homebrew8088/8088PCB/Kicad/Breadboard Adapter/Breadboard Adapter.kicad_pcb

## KiCad design Kicad/Breadboard Adapter/Breadboard Adapter.kicad_pcb (2025-01-31)

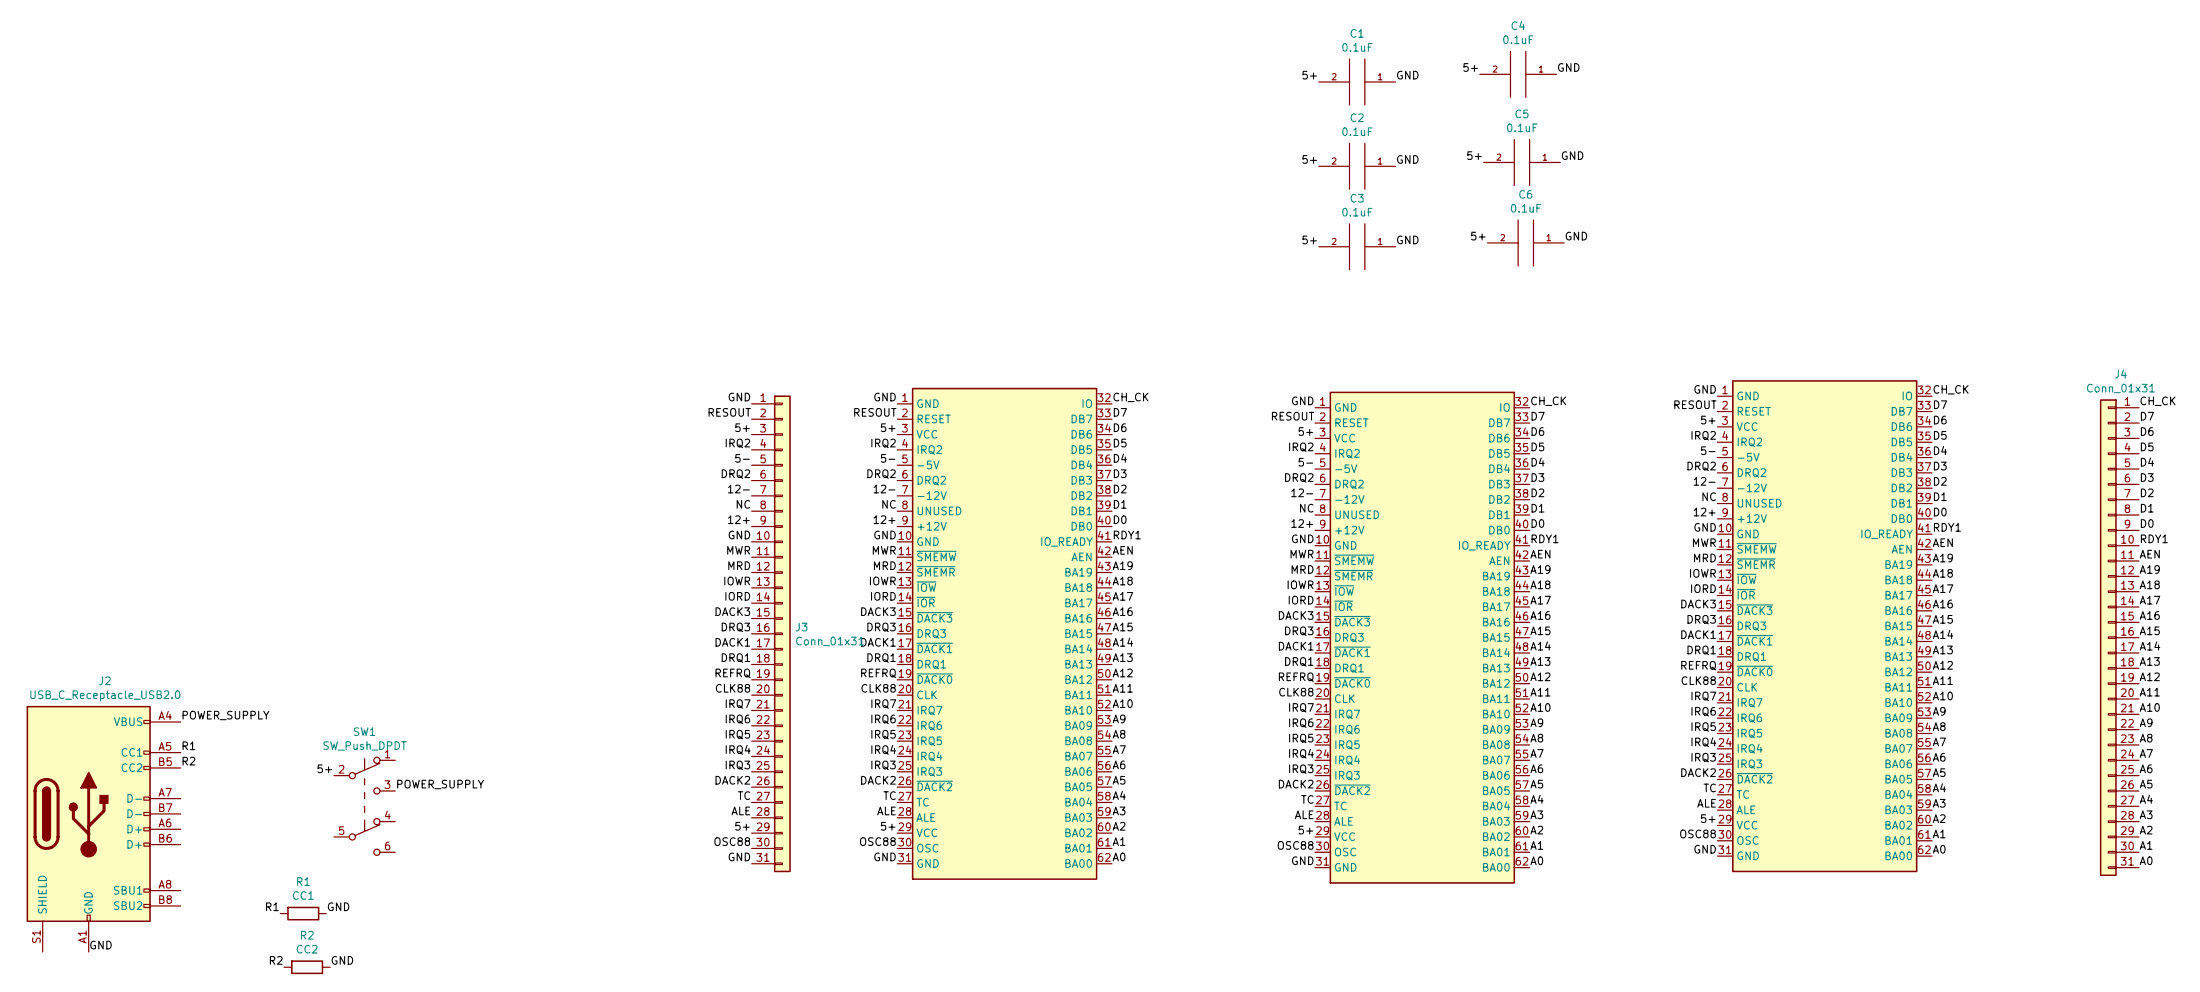
[picture p1: schematic Breadboard Adapter.sch]

Parts:
C1, C2, C3, C4, C5, C6: 0.1uF; C_Disc_D4.3mm_W1.9mm_P5.00mm
J1, J5, J9: Bus_ISA_8bit; 8-bit-ISA
J2: USB_C_Receptacle_USB2.0; USB_C_Receptacle_GCT_USB4085
J3, J4: Conn_01x31; PinHeader_1x31_P2.54mm_Vertical
R1: CC1; R_Axial_DIN0207_L6.3mm_D2.5mm_P10.16mm_Horizontal
R2: CC2; R_Axial_DIN0207_L6.3mm_D2.5mm_P10.16mm_Horizontal
SW1: SW_Push_DPDT; 6 PIN DTDP

Connections:
/5+: C1.2, C2.2, C3.2, C4.2, C5.2, C6.2, J1.3 (VCC), J1.29 (VCC), J3.3, J3.29, J5.3 (VCC), J5.29 (VCC), J9.3 (VCC), J9.29 (VCC), SW1.2 (B)
/5-: J1.5 (-5V), J3.5, J5.5 (-5V), J9.5 (-5V)
/12+: J1.9 (+12V), J3.9, J5.9 (+12V), J9.9 (+12V)
/12-: J1.7 (-12V), J3.7, J5.7 (-12V), J9.7 (-12V)
/A0: J1.62 (BA00), J4.31, J5.62 (BA00), J9.62 (BA00)
/A1: J1.61 (BA01), J4.30, J5.61 (BA01), J9.61 (BA01)
/A2: J1.60 (BA02), J4.29, J5.60 (BA02), J9.60 (BA02)
/A3: J1.59 (BA03), J4.28, J5.59 (BA03), J9.59 (BA03)
/A4: J1.58 (BA04), J4.27, J5.58 (BA04), J9.58 (BA04)
/A5: J1.57 (BA05), J4.26, J5.57 (BA05), J9.57 (BA05)
/A6: J1.56 (BA06), J4.25, J5.56 (BA06), J9.56 (BA06)
/A7: J1.55 (BA07), J4.24, J5.55 (BA07), J9.55 (BA07)
/A8: J1.54 (BA08), J4.23, J5.54 (BA08), J9.54 (BA08)
/A9: J1.53 (BA09), J4.22, J5.53 (BA09), J9.53 (BA09)
/A10: J1.52 (BA10), J4.21, J5.52 (BA10), J9.52 (BA10)
/A11: J1.51 (BA11), J4.20, J5.51 (BA11), J9.51 (BA11)
/A12: J1.50 (BA12), J4.19, J5.50 (BA12), J9.50 (BA12)
/A13: J1.49 (BA13), J4.18, J5.49 (BA13), J9.49 (BA13)
/A14: J1.48 (BA14), J4.17, J5.48 (BA14), J9.48 (BA14)
/A15: J1.47 (BA15), J4.16, J5.47 (BA15), J9.47 (BA15)
/A16: J1.46 (BA16), J4.15, J5.46 (BA16), J9.46 (BA16)
/A17: J1.45 (BA17), J4.14, J5.45 (BA17), J9.45 (BA17)
/A18: J1.44 (BA18), J4.13, J5.44 (BA18), J9.44 (BA18)
/A19: J1.43 (BA19), J4.12, J5.43 (BA19), J9.43 (BA19)
/AEN: J1.42 (AEN), J4.11, J5.42 (AEN), J9.42 (AEN)
/ALE: J1.28 (ALE), J3.28, J5.28 (ALE), J9.28 (ALE)
/CH_CK: J1.32 (IO), J4.1, J5.32 (IO), J9.32 (IO)
/CLK88: J1.20 (CLK), J3.20, J5.20 (CLK), J9.20 (CLK)
/D0: J1.40 (DB0), J4.9, J5.40 (DB0), J9.40 (DB0)
/D1: J1.39 (DB1), J4.8, J5.39 (DB1), J9.39 (DB1)
/D2: J1.38 (DB2), J4.7, J5.38 (DB2), J9.38 (DB2)
/D3: J1.37 (DB3), J4.6, J5.37 (DB3), J9.37 (DB3)
/D4: J1.36 (DB4), J4.5, J5.36 (DB4), J9.36 (DB4)
/D5: J1.35 (DB5), J4.4, J5.35 (DB5), J9.35 (DB5)
/D6: J1.34 (DB6), J4.3, J5.34 (DB6), J9.34 (DB6)
/D7: J1.33 (DB7), J4.2, J5.33 (DB7), J9.33 (DB7)
/DACK1: J1.17 (~DACK1), J3.17, J5.17 (~DACK1), J9.17 (~DACK1)
/DACK2: J1.26 (~DACK2), J3.26, J5.26 (~DACK2), J9.26 (~DACK2)
/DACK3: J1.15 (~DACK3), J3.15, J5.15 (~DACK3), J9.15 (~DACK3)
/DRQ1: J1.18 (DRQ1), J3.18, J5.18 (DRQ1), J9.18 (DRQ1)
/DRQ2: J1.6 (DRQ2), J3.6, J5.6 (DRQ2), J9.6 (DRQ2)
/DRQ3: J1.16 (DRQ3), J3.16, J5.16 (DRQ3), J9.16 (DRQ3)
/GND: C1.1, C2.1, C3.1, C4.1, C5.1, C6.1, J1.1 (GND), J1.10 (GND), J1.31 (GND), J2.A1 (GND), J2.A12 (GND), J2.B1 (GND), J2.B12 (GND), J3.1, J3.10, J3.31, J5.1 (GND), J5.10 (GND), J5.31 (GND), J9.1 (GND), J9.10 (GND), J9.31 (GND), R1.1, R2.1
/IORD: J1.14 (~IOR), J3.14, J5.14 (~IOR), J9.14 (~IOR)
/IOWR: J1.13 (~IOW), J3.13, J5.13 (~IOW), J9.13 (~IOW)
/IRQ2: J1.4 (IRQ2), J3.4, J5.4 (IRQ2), J9.4 (IRQ2)
/IRQ3: J1.25 (IRQ3), J3.25, J5.25 (IRQ3), J9.25 (IRQ3)
/IRQ4: J1.24 (IRQ4), J3.24, J5.24 (IRQ4), J9.24 (IRQ4)
/IRQ5: J1.23 (IRQ5), J3.23, J5.23 (IRQ5), J9.23 (IRQ5)
/IRQ6: J1.22 (IRQ6), J3.22, J5.22 (IRQ6), J9.22 (IRQ6)
/IRQ7: J1.21 (IRQ7), J3.21, J5.21 (IRQ7), J9.21 (IRQ7)
/MRD: J1.12 (~SMEMR), J3.12, J5.12 (~SMEMR), J9.12 (~SMEMR)
/MWR: J1.11 (~SMEMW), J3.11, J5.11 (~SMEMW), J9.11 (~SMEMW)
/NC: J1.8 (UNUSED), J3.8, J5.8 (UNUSED), J9.8 (UNUSED)
/OSC88: J1.30 (OSC), J3.30, J5.30 (OSC), J9.30 (OSC)
/POWER_SUPPLY: J2.A4 (VBUS), J2.A9 (VBUS), J2.B4 (VBUS), J2.B9 (VBUS), SW1.3 (C)
/R1: J2.A5 (CC1), R1.2
/R2: J2.B5 (CC2), R2.2
/RDY1: J1.41 (IO_READY), J4.10, J5.41 (IO_READY), J9.41 (IO_READY)
/REFRQ: J1.19 (~DACK0), J3.19, J5.19 (~DACK0), J9.19 (~DACK0)
/RESOUT: J1.2 (RESET), J3.2, J5.2 (RESET), J9.2 (RESET)
/TC: J1.27 (TC), J3.27, J5.27 (TC), J9.27 (TC)

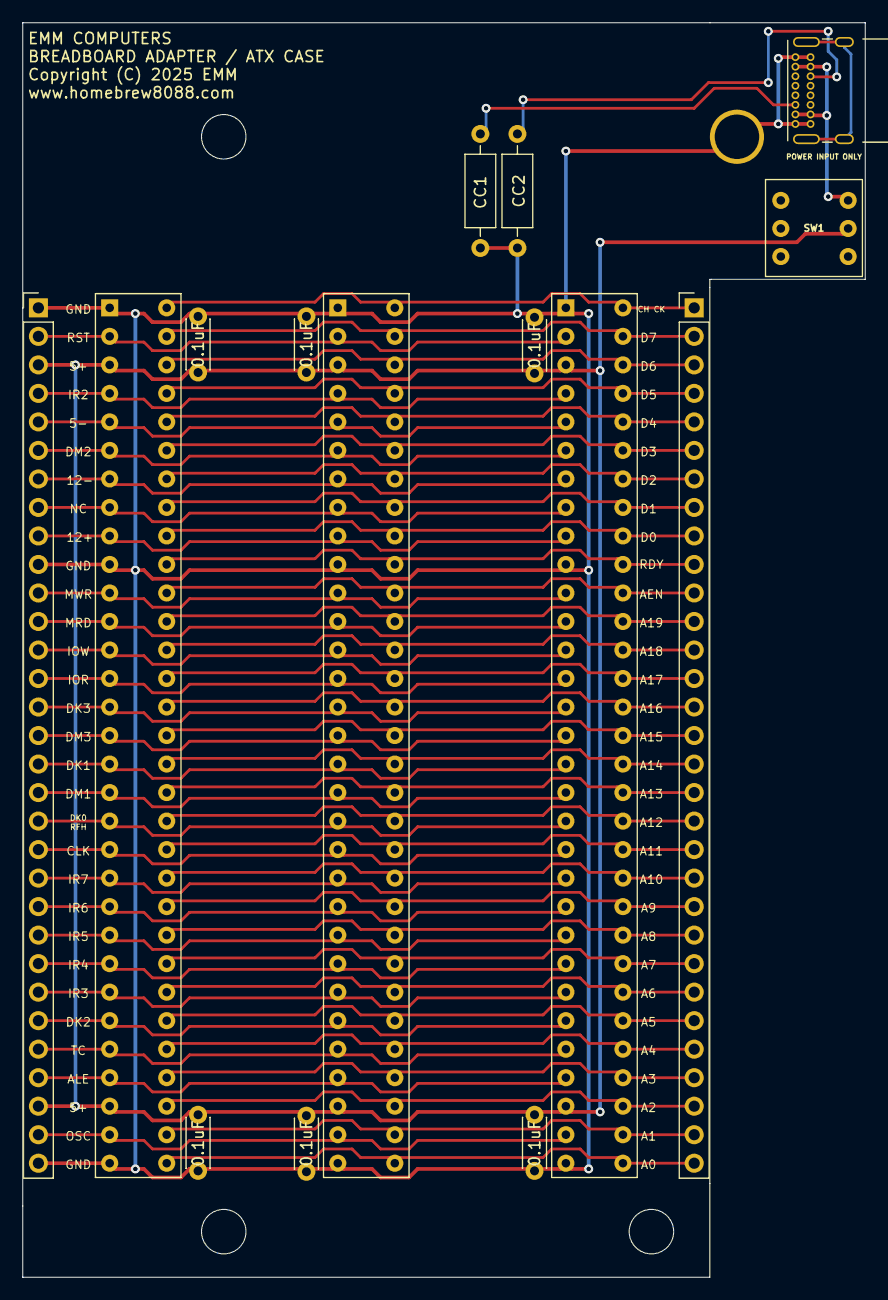
[picture p2: board Breadboard Adapter.kicad_pcb from above]

Board: 2 copper layers, 75.1 x 111.8 mm, 15 parts (0 on the bottom side), 62 nets.
