homebrew8088/8088PCB/Kicad/Motherboard/8088 PCB.kicad_pcb

## KiCad design Kicad/Motherboard/8088 PCB.kicad_pcb (2024-06-24)

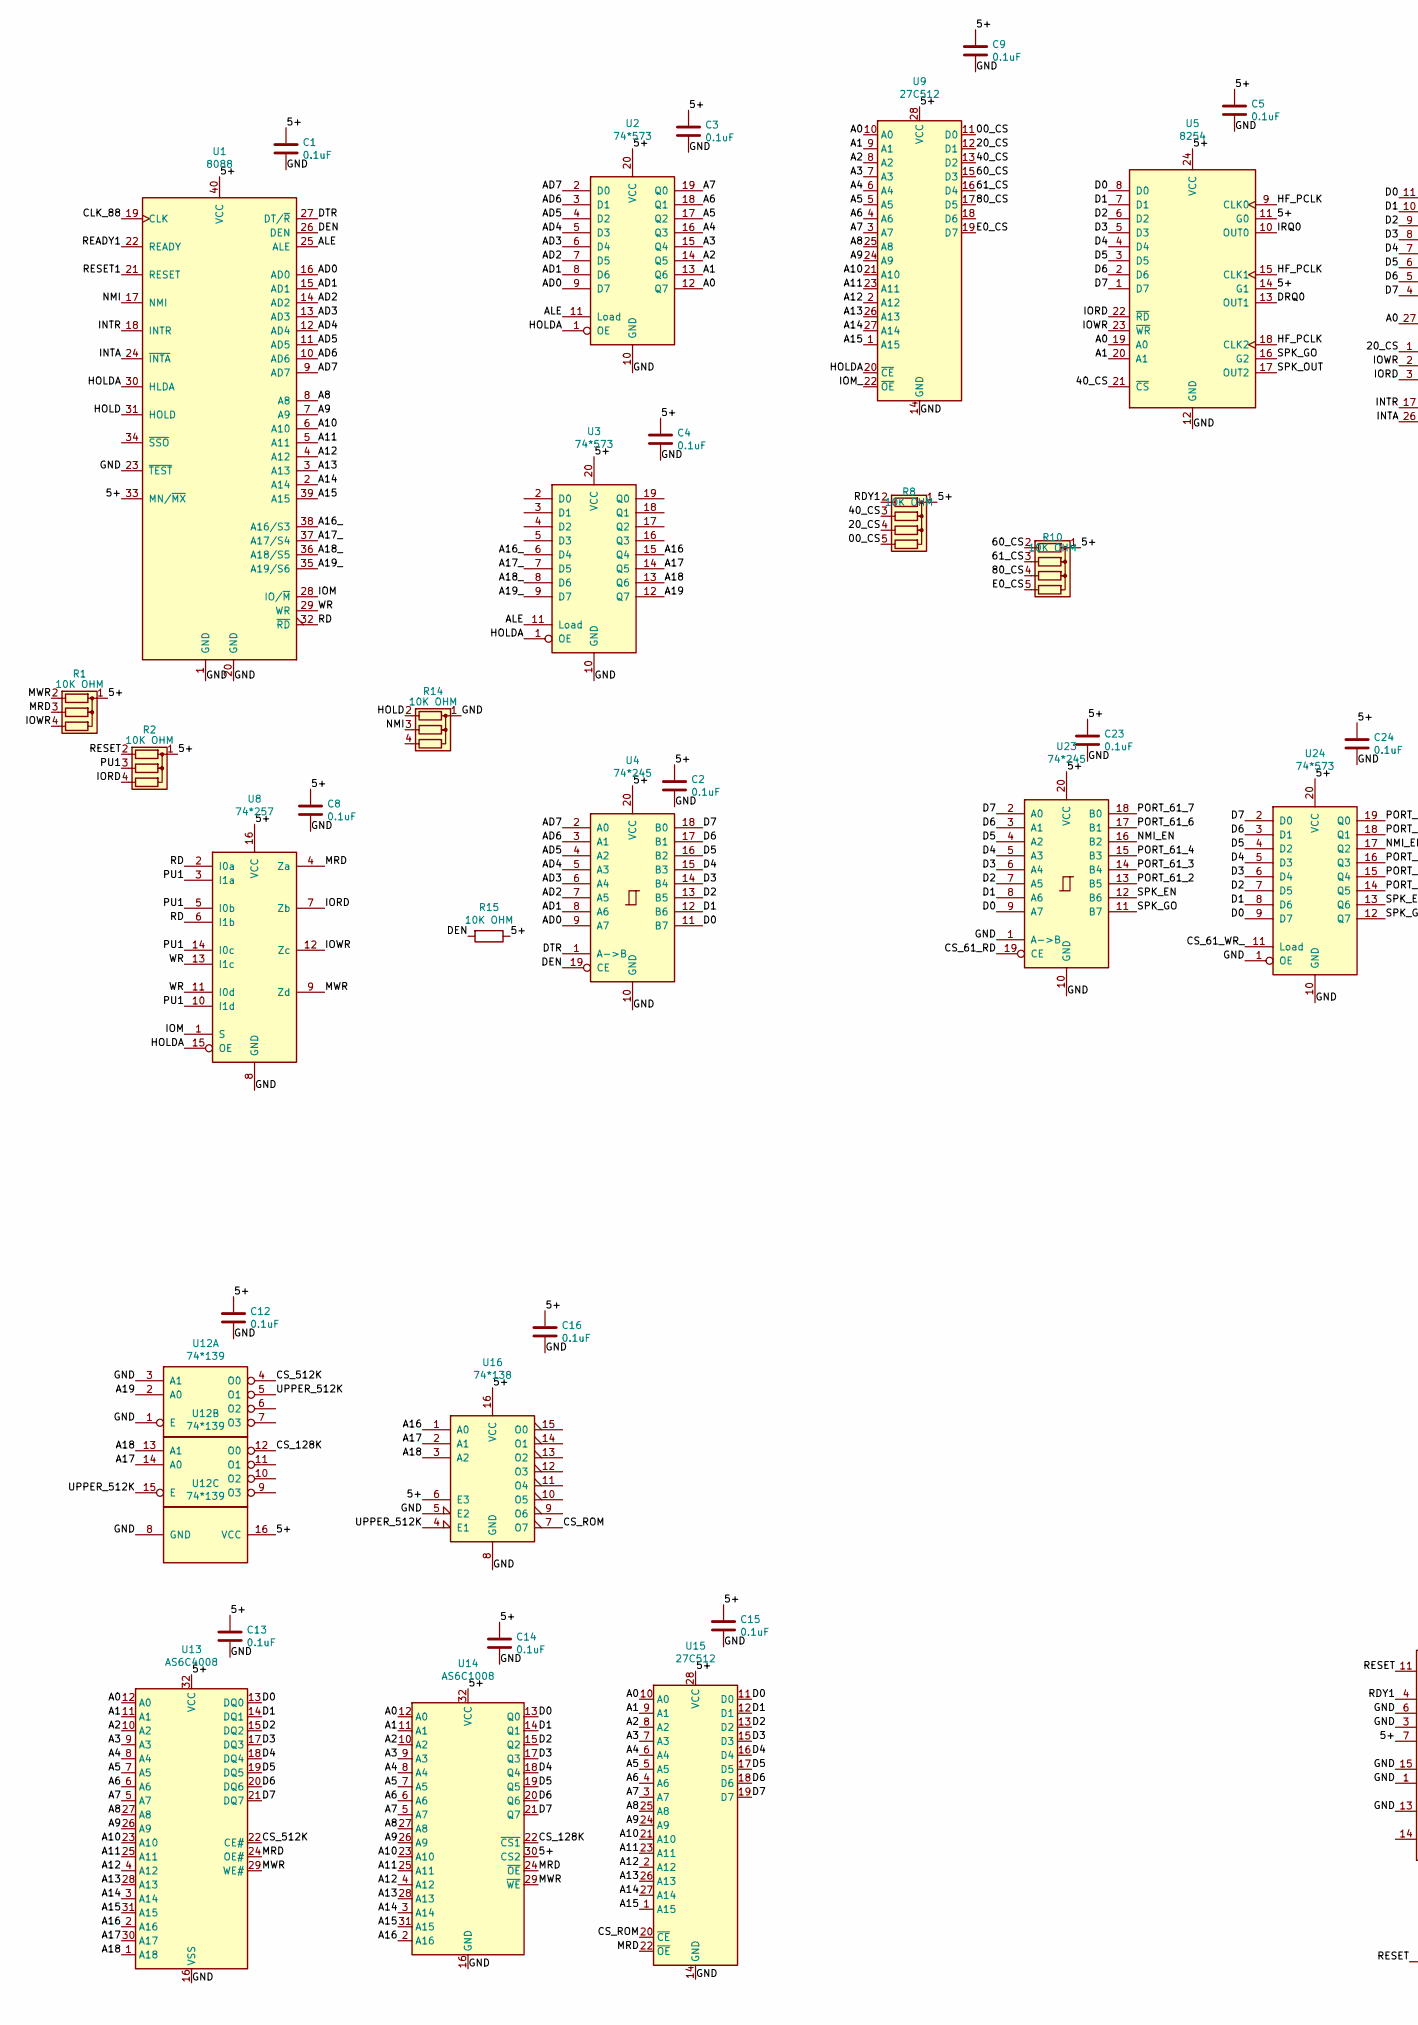
[picture p3: schematic 8088 PCB.sch, part in row 1, column 1]

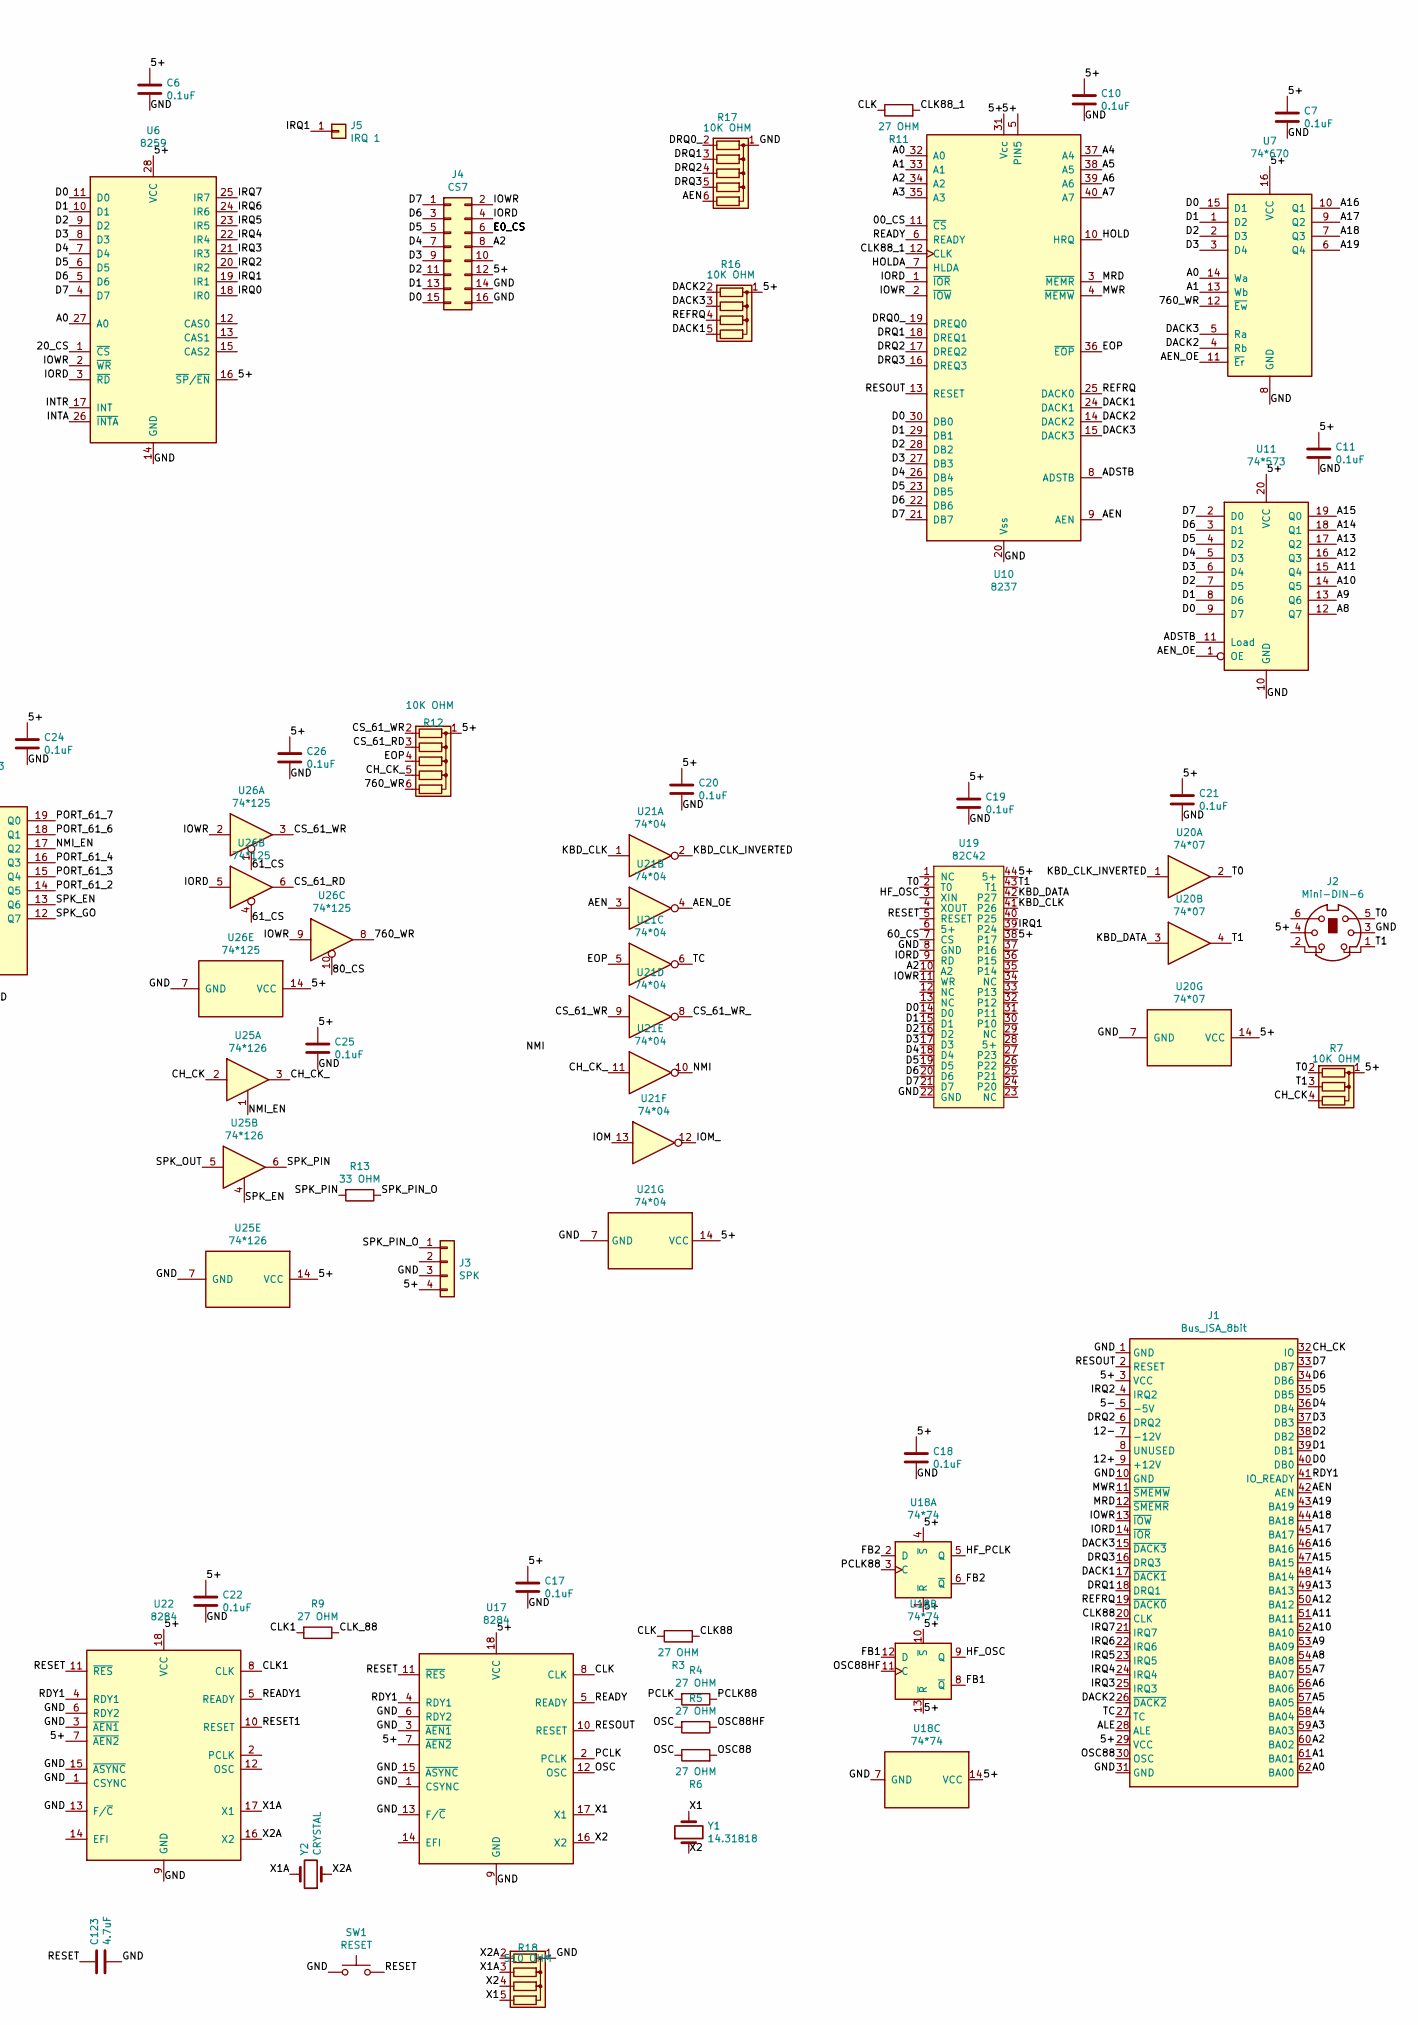
[picture p4: schematic 8088 PCB.sch, part in row 1, column 2]

Parts:
C1, C2, C3, C4, C5, C6, C7, C8, C9, C10, C11, C12, C13, C14, C15, C16, C17, C18, C19, C20, C21, C22, C23, C24, C25, C26: 0.1uF; C_Disc_D4.3mm_W1.9mm_P5.00mm
C123: 4.7uF; CP_Radial_D4.0mm_P1.50mm
J1: Bus_ISA_8bit; BUS_8_BIT
J2: Mini-DIN-6; 6_PIN_DIN
J3: SPK; PinHeader_1x04_P2.54mm_Vertical
J4: CS7; PinHeader_2x08_P2.54mm_Vertical
J5: IRQ 1; PinHeader_1x01_P2.54mm_Vertical
R1, R2, R7, R14: 10K OHM; R_Array_SIP4
R3, R4, R5, R6, R9, R11: 27 OHM; R_Axial_DIN0207_L6.3mm_D2.5mm_P10.16mm_Horizontal
R8, R10, R16: 10K OHM; R_Array_SIP5
R12, R17: 10K OHM; R_Array_SIP6
R13: 33 OHM; R_Axial_DIN0207_L6.3mm_D2.5mm_P10.16mm_Horizontal
R15: 10K OHM; R_Axial_DIN0207_L6.3mm_D2.5mm_P10.16mm_Horizontal
R18: 510 OHM; R_Array_SIP5
SW1: RESET; SW_PUSH_6mm
U1: 8088; DIP-40_W15.24mm
U2, U3, U11, U24: 74*573; DIP-20_W7.62mm
U4, U23: 74*245; DIP-20_W7.62mm
U5: 8254; DIP-24_W15.24mm
U6: 8259; DIP-28_W15.24mm
U7: 74*670; DIP-16_W7.62mm
U8: 74*257; DIP-16_W7.62mm
U9, U15: 27C512; DIP-28_W15.24mm
U10: 8237; DIP-40_W15.24mm
U12: 74*139; DIP-16_W7.62mm
U13: AS6C4008; DIP-32_W15.24mm
U14: AS6C1008; DIP-32_W15.24mm
U16: 74*138; DIP-16_W7.62mm
U17, U22: 8284; DIP-18_W7.62mm
U18: 74*74; DIP-14_W7.62mm
U19: 82C42; PLCC-44_THT-Socket
U20: 74*07; DIP-14_W7.62mm
U21: 74*04; DIP-14_W7.62mm
U25: 74*126; DIP-14_W7.62mm
U26: 74*125; DIP-14_W7.62mm
Y1: 14.31818; Crystal_HC18-U_Vertical
Y2: CRYSTAL; Crystal_HC18-U_Vertical

Connections:
/00_CS: R8.5 (R4), U9.11 (D0), U10.11 (~CS~)
/5+: C1.1, C2.1, C3.1, C4.1, C5.1, C6.1, C7.1, C8.1, C9.1, C10.1, C11.1, C12.1, C13.1, C14.1, C15.1, C16.1, C17.1, C18.1, C19.1, C20.1, C21.1, C22.1, C23.1, C24.1, C25.1, C26.1, J1.3 (VCC), J1.29 (VCC), J2.4, J3.4, J4.12, R1.1 (common), R2.1 (common), R7.1 (common), R8.1 (common), R10.1 (common), R12.1 (common), R15.1, R16.1 (common), U1.33 (MN/~MX~), U1.40 (VCC), U2.20 (VCC), U3.20 (VCC), U4.20 (VCC), U5.11 (G0), U5.14 (G1), U5.24 (VCC), U6.16 (~SP~/~EN~), U6.28 (VCC), U7.16 (VCC), U8.16 (VCC), U9.28 (VCC), U10.5 (PIN5), U10.31 (Vcc), U11.20 (VCC), U12.16 (VCC), U13.32 (VCC), U14.30 (CS2), U14.32 (VCC), U15.28 (VCC), U16.6 (E3), U16.16 (VCC), U17.7 (~AEN2~), U17.18 (VCC), U18.1 (~R), U18.4 (~S), U18.10 (~S), U18.13 (~R), U18.14 (VCC), U19.38 (P17), U19.44 (5+), U20.14 (VCC), U21.14 (VCC), U22.7 (~AEN2~), U22.18 (VCC), U23.20 (VCC), U24.20 (VCC), U25.14 (VCC), U26.14 (VCC)
/5-: J1.5 (-5V)
/12+: J1.9 (+12V)
/12-: J1.7 (-12V)
/20_CS: R8.4 (R3), U6.1 (~CS~), U9.12 (D1)
/40_CS: R8.3 (R2), U5.21 (~CS~), U9.13 (D2)
/60_CS: R10.2 (R1), U9.15 (D3), U19.7 (CS)
/61_CS: R10.3 (R2), U9.16 (D4), U26.1, U26.4
/80_CS: R10.4 (R3), U9.17 (D5), U26.10
/760_WR: R12.6 (R5), U7.12 (~Ew), U26.8
/A0: J1.62 (BA00), U2.12 (Q7), U5.19 (A0), U6.27 (A0), U7.14 (Wa), U9.10 (A0), U10.32 (A0), U13.12 (A0), U14.12 (A0), U15.10 (A0)
/A1: J1.61 (BA01), U2.13 (Q6), U5.20 (A1), U7.13 (Wb), U9.9 (A1), U10.33 (A1), U13.11 (A1), U14.11 (A1), U15.9 (A1)
/A2: J1.60 (BA02), J4.8, U2.14 (Q5), U9.8 (A2), U10.34 (A2), U13.10 (A2), U14.10 (A2), U15.8 (A2), U19.10 (A2)
/A3: J1.59 (BA03), U2.15 (Q4), U9.7 (A3), U10.35 (A3), U13.9 (A3), U14.9 (A3), U15.7 (A3)
/A4: J1.58 (BA04), U2.16 (Q3), U9.6 (A4), U10.37 (A4), U13.8 (A4), U14.8 (A4), U15.6 (A4)
/A5: J1.57 (BA05), U2.17 (Q2), U9.5 (A5), U10.38 (A5), U13.7 (A5), U14.7 (A5), U15.5 (A5)
/A6: J1.56 (BA06), U2.18 (Q1), U9.4 (A6), U10.39 (A6), U13.6 (A6), U14.6 (A6), U15.4 (A6)
/A7: J1.55 (BA07), U2.19 (Q0), U9.3 (A7), U10.40 (A7), U13.5 (A7), U14.5 (A7), U15.3 (A7)
/A8: J1.54 (BA08), U1.8 (A8), U9.25 (A8), U11.12 (Q7), U13.27 (A8), U14.27 (A8), U15.25 (A8)
/A9: J1.53 (BA09), U1.7 (A9), U9.24 (A9), U11.13 (Q6), U13.26 (A9), U14.26 (A9), U15.24 (A9)
/A10: J1.52 (BA10), U1.6 (A10), U9.21 (A10), U11.14 (Q5), U13.23 (A10), U14.23 (A10), U15.21 (A10)
/A11: J1.51 (BA11), U1.5 (A11), U9.23 (A11), U11.15 (Q4), U13.25 (A11), U14.25 (A11), U15.23 (A11)
/A12: J1.50 (BA12), U1.4 (A12), U9.2 (A12), U11.16 (Q3), U13.4 (A12), U14.4 (A12), U15.2 (A12)
/A13: J1.49 (BA13), U1.3 (A13), U9.26 (A13), U11.17 (Q2), U13.28 (A13), U14.28 (A13), U15.26 (A13)
/A14: J1.48 (BA14), U1.2 (A14), U9.27 (A14), U11.18 (Q1), U13.3 (A14), U14.3 (A14), U15.27 (A14)
/A15: J1.47 (BA15), U1.39 (A15), U9.1 (A15), U11.19 (Q0), U13.31 (A15), U14.31 (A15), U15.1 (A15)
/A16: J1.46 (BA16), U3.15 (Q4), U7.10 (Q1), U13.2 (A16), U14.2 (A16), U16.1 (A0)
/A16_: U1.38 (A16/S3), U3.6 (D4)
/A17: J1.45 (BA17), U3.14 (Q5), U7.9 (Q2), U12.14 (A0), U13.30 (A17), U16.2 (A1)
/A17_: U1.37 (A17/S4), U3.7 (D5)
/A18: J1.44 (BA18), U3.13 (Q6), U7.7 (Q3), U12.13 (A1), U13.1 (A18), U16.3 (A2)
/A18_: U1.36 (A18/S5), U3.8 (D6)
/A19: J1.43 (BA19), U3.12 (Q7), U7.6 (Q4), U12.2 (A0)
/A19_: U1.35 (A19/S6), U3.9 (D7)
/AD0: U1.16 (AD0), U2.9 (D7), U4.9 (A7)
/AD1: U1.15 (AD1), U2.8 (D6), U4.8 (A6)
/AD2: U1.14 (AD2), U2.7 (D5), U4.7 (A5)
/AD3: U1.13 (AD3), U2.6 (D4), U4.6 (A4)
/AD4: U1.12 (AD4), U2.5 (D3), U4.5 (A3)
/AD5: U1.11 (AD5), U2.4 (D2), U4.4 (A2)
/AD6: U1.10 (AD6), U2.3 (D1), U4.3 (A1)
/AD7: U1.9 (AD7), U2.2 (D0), U4.2 (A0)
/ADSTB: U10.8 (ADSTB), U11.11 (Load)
/AEN: J1.42 (AEN), R17.6 (R5), U10.9 (AEN), U21.3
/AEN_OE: U7.11 (~Er), U11.1 (OE), U21.4
/ALE: J1.28 (ALE), U1.25 (ALE), U2.11 (Load), U3.11 (Load)
/CH_CK: J1.32 (IO), R7.4 (R3), U25.2
/CH_CK_: R12.5 (R4), U21.11, U25.3
/CLK: R3.1, R11.1, U17.8 (CLK)
/CLK1: R9.2, U22.8 (CLK)
/CLK88: J1.20 (CLK), R3.2
/CLK88_1: R11.2, U10.12 (CLK)
/CLK_88: R9.1, U1.19 (CLK)
/CS_61_RD: R12.3 (R2), U23.19 (CE), U26.6
/CS_61_WR: R12.2 (R1), U21.9, U26.3
/CS_61_WR_: U21.8, U24.11 (Load)
/CS_128K: U12.12 (O0), U14.22 (~CS1)
/CS_512K: U12.4 (O0), U13.22 (CE#)
/CS_ROM: U15.20 (~CE), U16.7 (O7)
/D0: J1.40 (DB0), J4.15, U4.11 (B7), U5.8 (D0), U6.11 (D0), U7.15 (D1), U10.30 (DB0), U11.9 (D7), U13.13 (DQ0), U14.13 (Q0), U15.11 (D0), U19.14 (D0), U23.9 (A7), U24.9 (D7)
/D1: J1.39 (DB1), J4.13, U4.12 (B6), U5.7 (D1), U6.10 (D1), U7.1 (D2), U10.29 (DB1), U11.8 (D6), U13.14 (DQ1), U14.14 (Q1), U15.12 (D1), U19.15 (D1), U23.8 (A6), U24.8 (D6)
/D2: J1.38 (DB2), J4.11, U4.13 (B5), U5.6 (D2), U6.9 (D2), U7.2 (D3), U10.28 (DB2), U11.7 (D5), U13.15 (DQ2), U14.15 (Q2), U15.13 (D2), U19.16 (D2), U23.7 (A5), U24.7 (D5)
/D3: J1.37 (DB3), J4.9, U4.14 (B4), U5.5 (D3), U6.8 (D3), U7.3 (D4), U10.27 (DB3), U11.6 (D4), U13.17 (DQ3), U14.17 (Q3), U15.15 (D3), U19.17 (D3), U23.6 (A4), U24.6 (D4)
/D4: J1.36 (DB4), J4.7, U4.15 (B3), U5.4 (D4), U6.7 (D4), U10.26 (DB4), U11.5 (D3), U13.18 (DQ4), U14.18 (Q4), U15.16 (D4), U19.18 (D4), U23.5 (A3), U24.5 (D3)
/D5: J1.35 (DB5), J4.5, U4.16 (B2), U5.3 (D5), U6.6 (D5), U10.23 (DB5), U11.4 (D2), U13.19 (DQ5), U14.19 (Q5), U15.17 (D5), U19.19 (D5), U23.4 (A2), U24.4 (D2)
/D6: J1.34 (DB6), J4.3, U4.17 (B1), U5.2 (D6), U6.5 (D6), U10.22 (DB6), U11.3 (D1), U13.20 (DQ6), U14.20 (Q6), U15.18 (D6), U19.20 (D6), U23.3 (A1), U24.3 (D1)
/D7: J1.33 (DB7), J4.1, U4.18 (B0), U5.1 (D7), U6.4 (D7), U10.21 (DB7), U11.2 (D0), U13.21 (DQ7), U14.21 (Q7), U15.19 (D7), U19.21 (D7), U23.2 (A0), U24.2 (D0)
/DACK1: J1.17 (~DACK1), R16.5 (R4), U10.24 (DACK1)
/DACK2: J1.26 (~DACK2), R16.2 (R1), U7.4 (Rb), U10.14 (DACK2)
/DACK3: J1.15 (~DACK3), R16.3 (R2), U7.5 (Ra), U10.15 (DACK3)
/DEN: R15.2, U1.26 (DEN), U4.19 (CE)
/DRQ0: U5.13 (OUT1)
/DRQ0_: R17.2 (R1), U10.19 (DREQ0)
/DRQ1: J1.18 (DRQ1), R17.3 (R2), U10.18 (DREQ1)
/DRQ2: J1.6 (DRQ2), R17.4 (R3), U10.17 (DREQ2)
/DRQ3: J1.16 (DRQ3), R17.5 (R4), U10.16 (DREQ3)
/DTR: U1.27 (DT/~R~), U4.1 (A->B)
/E0_CS: J4.6, R10.5 (R4), U9.19 (D7)
/EOP: R12.4 (R3), U10.36 (~EOP~), U21.5
/FB1: U18.8 (~Q), U18.12 (D)
/FB2: U18.2 (D), U18.6 (~Q)
/GND: C1.2, C2.2, C3.2, C4.2, C5.2, C6.2, C7.2, C8.2, C9.2, C10.2, C11.2, C12.2, C13.2, C14.2, C15.2, C16.2, C17.2, C18.2, C19.2, C20.2, C21.2, C22.2, C23.2, C24.2, C25.2, C26.2, C123.2, J1.1 (GND), J1.10 (GND), J1.31 (GND), J2.3, J3.3, J4.14, J4.16, R14.1 (common), R17.1 (common), R18.1 (common), SW1.1, U1.1 (GND), U1.20 (GND), U1.23 (~TEST~), U2.10 (GND), U3.10 (GND), U4.10 (GND), U5.12 (GND), U6.14 (GND), U7.8 (GND), U8.8 (GND), U9.14 (GND), U10.20 (Vss), U11.10 (GND), U12.1 (E), U12.3 (A1), U12.8 (GND), U13.16 (VSS), U14.16 (GND), U15.14 (GND), U16.5 (E2), U16.8 (GND), U17.1 (CSYNC), U17.3 (~AEN1~), U17.6 (RDY2), U17.9 (GND), U17.13 (F/~C~), U17.15 (~ASYNC~), U18.7 (GND), U19.8 (GND), U19.22 (GND), U20.7 (GND), U21.7 (GND), U22.1 (CSYNC), U22.3 (~AEN1~), U22.6 (RDY2), U22.9 (GND), U22.13 (F/~C~), U22.15 (~ASYNC~), U23.1 (A->B), U23.10 (GND), U24.1 (OE), U24.10 (GND), U25.7 (GND), U26.7 (GND); also elsewhere on the board
/HF_OSC: U18.9 (Q), U19.3 (XIN)
/HF_PCLK: U5.9 (CLK0), U5.15 (CLK1), U5.18 (CLK2), U18.5 (Q)
/HOLD: R14.2 (R1), U1.31 (HOLD), U10.10 (HRQ)
/HOLDA: U1.30 (HLDA), U2.1 (OE), U3.1 (OE), U8.15 (OE), U9.20 (~CE), U10.7 (HLDA)
/INTA: U1.24 (~INTA~), U6.26 (~INTA~)
/INTR: U1.18 (INTR), U6.17 (INT)
/IOM: U1.28 (IO/~M~), U8.1 (S), U21.13
/IOM_: U9.22 (~OE), U21.12
/IORD: J1.14 (~IOR), J4.4, R2.4 (R3), U5.22 (~RD~), U6.3 (~RD~), U8.7 (Zb), U10.1 (~IOR~), U19.9 (RD), U26.5
/IOWR: J1.13 (~IOW), J4.2, R1.4 (R3), U5.23 (~WR~), U6.2 (~WR~), U8.12 (Zc), U10.2 (~IOW~), U19.11 (WR), U26.2, U26.9
/IRQ0: U5.10 (OUT0), U6.18 (IR0)
/IRQ1: J5.1, U6.19 (IR1), U19.39 (P24)
/IRQ2: J1.4 (IRQ2), U6.20 (IR2)
/IRQ3: J1.25 (IRQ3), U6.21 (IR3)
/IRQ4: J1.24 (IRQ4), U6.22 (IR4)
/IRQ5: J1.23 (IRQ5), U6.23 (IR5)
/IRQ6: J1.22 (IRQ6), U6.24 (IR6)
/IRQ7: J1.21 (IRQ7), U6.25 (IR7)
/KBD_CLK: U19.41 (P26), U21.1
/KBD_CLK_INVERTED: U20.1, U21.2
/KBD_DATA: U19.42 (P27), U20.3
/MRD: J1.12 (~SMEMR), R1.3 (R2), U8.4 (Za), U10.3 (~MEMR~), U13.24 (OE#), U14.24 (~OE), U15.22 (~OE)
/MWR: J1.11 (~SMEMW), R1.2 (R1), U8.9 (Zd), U10.4 (~MEMW~), U13.29 (WE#), U14.29 (~WE)
/NMI: R14.3 (R2), U1.17 (NMI), U21.10
/NMI_EN: U23.16 (B2), U24.17 (Q2), U25.1
/OSC: R5.2, R6.1, U17.12 (OSC)
/OSC88: J1.30 (OSC), R6.2
/OSC88HF: R5.1, U18.11 (C)
/PCLK: R4.2, U17.2 (PCLK)
/PCLK88: R4.1, U18.3 (C)
/PORT_61_2: U23.13 (B5), U24.14 (Q5)
/PORT_61_3: U23.14 (B4), U24.15 (Q4)
/PORT_61_4: U23.15 (B3), U24.16 (Q3)
/PORT_61_6: U23.17 (B1), U24.18 (Q1)
/PORT_61_7: U23.18 (B0), U24.19 (Q0)
/PU1: R2.3 (R2), U8.3 (I1a), U8.5 (I0b), U8.10 (I1d), U8.14 (I0c)
/RD: U1.32 (~RD~), U8.2 (I0a), U8.6 (I1b)
/RDY1: J1.41 (IO_READY), R8.2 (R1), U17.4 (RDY1), U22.4 (RDY1)
/READY: U10.6 (READY), U17.5 (READY)
/READY1: U1.22 (READY), U22.5 (READY)
/REFRQ: J1.19 (~DACK0), R16.4 (R3), U10.25 (DACK0)
/RESET: C123.1, R2.2 (R1), SW1.2, U17.11 (~RES~), U19.5 (RESET), U22.11 (~RES~)
/RESET1: U1.21 (RESET), U22.10 (RESET)
/RESOUT: J1.2 (RESET), U10.13 (RESET), U17.10 (RESET)
/SPK_EN: U23.12 (B6), U24.13 (Q6), U25.4
/SPK_GO: U5.16 (G2), U23.11 (B7), U24.12 (Q7)
/SPK_OUT: U5.17 (OUT2), U25.5
/SPK_PIN: R13.2, U25.6
/SPK_PIN_O: J3.1, R13.1
/T0: J2.5, R7.2 (R1), U19.2 (T0), U20.2
/T1: J2.1, R7.3 (R2), U19.43 (T1), U20.4
/TC: J1.27 (TC), U21.6
/UPPER_512K: U12.5 (O1), U12.15 (E), U16.4 (E1)
/WR: U1.29 (WR), U8.11 (I0d), U8.13 (I1c)
/X1: R18.5 (R4), U17.17 (X1), Y1.2
/X1A: R18.3 (R2), U22.17 (X1), Y2.2
/X2: R18.4 (R3), U17.16 (X2), Y1.1
/X2A: R18.2 (R1), U22.16 (X2), Y2.1

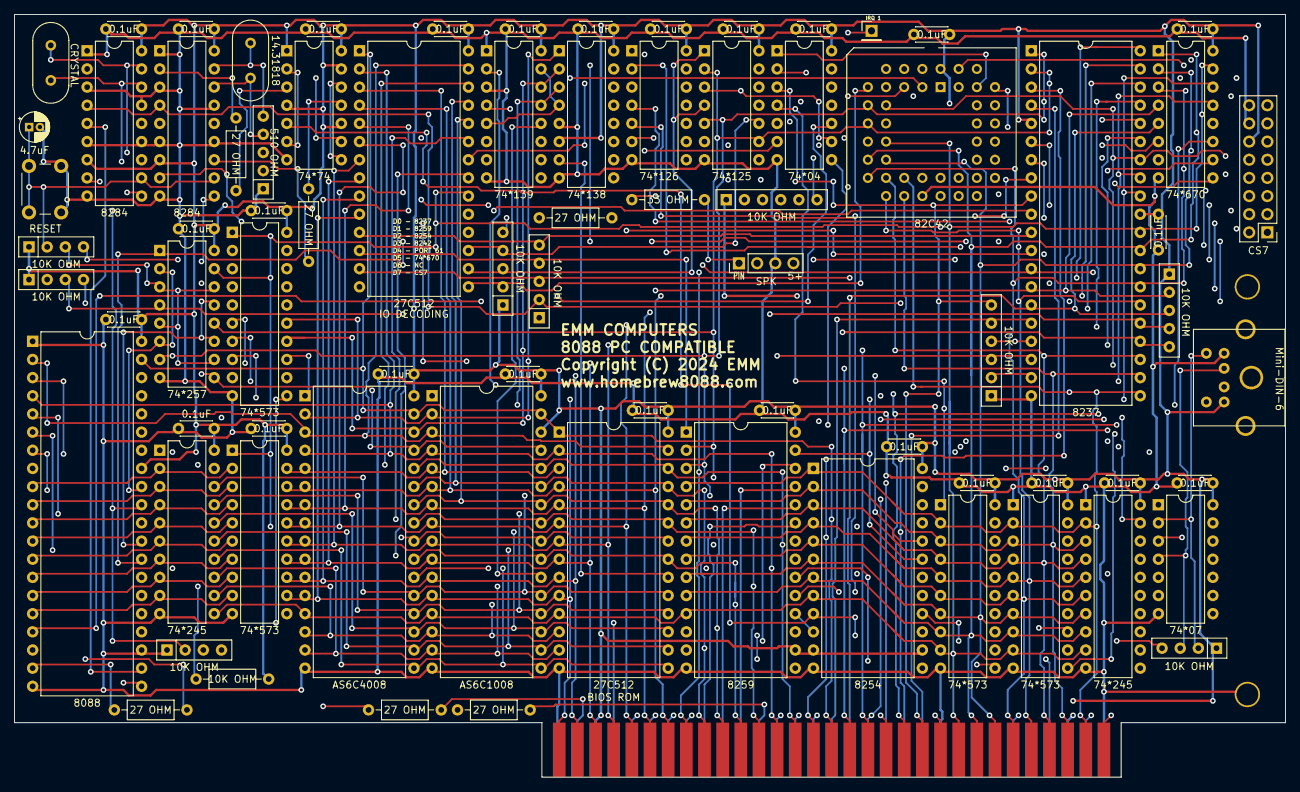
[picture p5: board 8088 PCB.kicad_pcb from above]

Board: 4 copper layers, 177.8 x 106.7 mm, 81 parts (0 on the bottom side), 137 nets.

Other parts of the board:
R: L; Large_Via
R#2: L; Large_Via

Their connections:
/GND: R#2.1; also elsewhere on the board
