homebrew8088/8088PCB/(commit log)

2024-05-03 Added CH376 conn
    [8088 PCB.kicad_pcb, 8088 PCB.sch]
2024-05-06 update for production
    [8088 PCB-B_Cu.gbr, 8088 PCB-B_Mask.gbr, 8088 PCB-B_Paste.gbr, 8088 PCB-B_SilkS.gbr, 8088 PCB-Edge_Cuts.gbr, 8088 PCB-F_Cu.gbr, 8088 PCB-F_Mask.gbr, 8088 PCB-F_Paste.gbr]
2024-05-17 17 May 24 build
    [8088 PCB-B_Cu.gbr, 8088 PCB-B_Mask.gbr, 8088 PCB-B_Paste.gbr, 8088 PCB-B_SilkS.gbr, 8088 PCB-Edge_Cuts.gbr, 8088 PCB-F_Cu.gbr, 8088 PCB-F_Mask.gbr, 8088 PCB-F_Paste.gbr]
2024-05-27 Update IRQ 1 pin
    [8088 PCB-B_Cu.gbr, 8088 PCB-B_Mask.gbr, 8088 PCB-B_Paste.gbr, 8088 PCB-B_SilkS.gbr, 8088 PCB-Edge_Cuts.gbr, 8088 PCB-F_Cu.gbr, 8088 PCB-F_Mask.gbr, 8088 PCB-F_Paste.gbr]
2024-05-28 update adapter
    [8088 PCB.kicad_pcb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]
2025-01-31 Up dated Breadboard adpater
    [Breadboard Adapter-B_Cu.gbr, Breadboard Adapter-B_Mask.gbr, Breadboard Adapter-B_Paste.gbr, Breadboard Adapter-B_SilkS.gbr, Breadboard Adapter-Edge_Cuts.gbr, Breadboard Adapter-F_Cu.gbr, Breadboard Adapter-F_Mask.gbr, Breadboard Adapter-F_Paste.gbr]
