homebrew8088/8088PCB/(notices)

Notices in the files:
Kicad/Breadboard Adapter/Breadboard Adapter.kicad_pcb:
Copyright (C) 2025 EMM
Kicad/Motherboard/8088 PCB.kicad_pcb:
Copyright (C) 2024 EMM
